Protonica-Detectors/hw-front-end/Output/Assembly/BOM-JLCPCB.csv

Comment | Designator | Footprint | LCSC Part #
10u GRM31CR71E106KA12L | C102,C104,C205,C206,C317,C318,C319,C320 | 1206 | C77093
100n GCM21BR72A104KA37L | C103,C201,C203,C204,C301,C302,C306,C307,C308,C311,C312,C313,C314,C315,C316 | 0805 | C85866
1u GRM21BR71H105KA12L | C202 | 0805 | C77083
4.7u GRM21BR71C475KE51L | C303,C304,C305 | 0805 | C408144
220p 0805CG221J500NT | C309,C310 | 0805 | C1805
SMAJ5.0A SMAJ5.0A | D101 | DO-214AC(SMA) | C83329
SMAJ12A SMAJ12A | D102 | DO-214AC(SMA) | C148213
BHR-24-VUA BHR-24-VUA | J101 | TH-24P,P=2.54mm | C7433299
Conn_02x04_Pin M20-9760442 | J201,J202 | Plugin,P=2.54mm | C5757776
Conn_02x06_Pin M20-9760642 | J301,J302,J303,J304 | Plugin,P=2.54mm | C5757778
2.2u MLF2012A2R2KT000 | L301,L302 | 0805 | C136256
0R CRCW08050000Z0EA | R101,R303,R304 | 0805 | C844934
1k CRCW08051K00FKEA | R201 | 0805 | C844939
200R CRCW0805200RFKEA | R301,R302 | 0805 | C844828
10k CRCW080510K0FKEA | R305,R306,R307,R308 | 0805 | C844937
100R CRCW0805100RFKEA | R311,R312,R313,R314,R315,R316,R317,R318,R319,R320,R321,R322 | 0805 | C844936
49.9R CRCW080549R9FKEA | R323,R324 | 0805 | C844847
75R CRCW080575R0FKEA | R325,R326 | 0805 | C844859
USBLC6-4SC6 USBLC6-4SC6 | U101,U102,U103 | SOT-23-6L | C111212
STP16CP05XT STP16CP05XTTR | U201 | TSSOP-24-EP | C2969824
OPA2350 OPA2350UA/2K5 | U301,U302 | SOIC-8 | C55904
SN74LVC16244ADGGR SN74LVC16244ADGGR | U303 | TSSOP-48-6.1mm | C7822
74LVC2G32 SN74LVC2G32DCTR | U304 | MSOP-8 | C2862085
