Protonica-Detectors/hw-front-end/Output/Assembly/BOM-original.csv

Reference | Value | Footprint | MPN | Manufacturer | Voltage | Description | QUANTITY | DNP | EXCLUDE_FROM_BOM | EXCLUDE_FROM_BOARD
C102,C104,C205,C206,C317,C318,C319,C320 | 10u | Capacitor_SMD:C_1206_3216Metric_Pad1.33x1.80mm_HandSolder | GRM31CR71E106KA12L | Murata Electronics | 25V | CAP CER 10UF 25V X7R 1206 | 8
C103,C201,C203,C204,C301,C302,C306,C307,C308,C311,C312,C313,C314,C315,C316 | 100n | Capacitor_SMD:C_0805_2012Metric_Pad1.18x1.45mm_HandSolder | GCM21BR72A104KA37L | Murata Electronics | 100V | CAP CER 0.1UF 100V X7R 0805 | 15
C202 | 1u | Capacitor_SMD:C_0805_2012Metric_Pad1.18x1.45mm_HandSolder | GRM21BR71A105KA01L | Murata Electronics | 10V | CAP CER 1UF 10V X7R 0805 | 1
C303,C304,C305 | 4.7u | Capacitor_SMD:C_0805_2012Metric_Pad1.18x1.45mm_HandSolder | GRM21BR71C475KE51L | Murata Electronics | 16V | CAP CER 4.7UF 16V X7R 0805 | 3
C309,C310 | 220p | Capacitor_SMD:C_0805_2012Metric_Pad1.18x1.45mm_HandSolder | C0805C221J5RACTU | Kemet | 50V | Unpolarized capacitor | 2
D101 | SMAJ5.0A | Diode_SMD:D_SMA | SMAJ5.0A | Littelfuse |  | 400W unidirectional Transient Voltage Suppressor, 5.0Vr, SMA(DO-214AC) | 1
D102 | SMAJ12A | Diode_SMD:D_SMA | SMAJ12A | Littelfuse |  | 400W unidirectional Transient Voltage Suppressor, 12.0Vr, SMA(DO-214AC) | 1
J101 | BHR-24-VUA | Connector_IDC:IDC-Header_2x12_P2.54mm_Vertical | BHR-24-VUA | Adam Tech |  | Generic connector, double row, 02x12, odd/even pin numbering scheme (row 1 odd numbers, row 2 even numbers), script generated (kicad-library-utils/schlib/autogen/connector/) | 1
J201,J202 | Conn_02x04_Pin | Connector_IDC:IDC-Header_2x04_P2.54mm_Vertical | M20-9760442 | Harwin Inc. |  | CONN HEADER VERT 8POS 2.54MM | 2
J301,J302,J303,J304 | Conn_02x06_Pin | Connector_IDC:IDC-Header_2x06_P2.54mm_Vertical | M20-9760642 | Harwin Inc. |  | CONN HEADER VERT 12POS 2.54MM | 4
L301,L302 | 2.2u | Inductor_SMD:L_0805_2012Metric | 74479052 | Würth Elektronik |  | Inductor | 2
R101,R303,R304 | 0R | Resistor_SMD:R_0805_2012Metric_Pad1.20x1.40mm_HandSolder | CRCW08050000Z0EA | Vishay Dale |  | RES SMD 0 OHM JUMPER 1/8W 0805 | 3
R201 | 1k | Resistor_SMD:R_0805_2012Metric_Pad1.20x1.40mm_HandSolder | CRCW08051K00FKEA | Vishay Dale |  | RES SMD 1K OHM 1% 1/4W 0805 | 1
R301,R302 | 200R | Resistor_SMD:R_0805_2012Metric_Pad1.20x1.40mm_HandSolder | CRCW0805200RFKEA | Vishay Dale |  | RES SMD 200 OHM 1% 1/8W 0805 | 2
R305,R306,R307,R308 | 10k | Resistor_SMD:R_0805_2012Metric_Pad1.20x1.40mm_HandSolder | CRCW080510K0FKEA | Vishay Dale |  | RES SMD 10K OHM 1% 1/8W 0805 | 4
R311,R312,R313,R314,R315,R316,R317,R318,R319,R320,R321,R322 | 100R | Resistor_SMD:R_0805_2012Metric_Pad1.20x1.40mm_HandSolder | CRCW0805100RFKEA | Vishay Dale |  | RES SMD 100 OHM 1% 1/8W 0805 | 12
R323,R324 | 49.9R | Resistor_SMD:R_0805_2012Metric_Pad1.20x1.40mm_HandSolder | CRCW080549R9FKEA | Vishay Dale |  | RES SMD 49.9 OHM 1% 1/8W 0805 | 2
R325,R326 | 75R | Resistor_SMD:R_0805_2012Metric_Pad1.20x1.40mm_HandSolder | CRCW080575R0FKEA | Vishay Dale |  | RES SMD 75 OHM 1% 1/8W 0805 | 2
U101,U102,U103 | USBLC6-4SC6 | Package_TO_SOT_SMD:SOT-23-6 | USBLC6-4SC6 | STMicroelectronics |  | Very low capacitance ESD protection diode, 4 data-line, SOT-23-6 | 3
U201 | STP16CP05XT | Package_SO:HTSSOP-24-1EP_4.4x7.8mm_P0.65mm_EP3.2x5mm | STP16CP05XTTR | STMicroelectronics |  | 16-bit constant current LED sink driver, 5..100mA output current, 20V driving capability, 3.0..5.5V power supply, HTSSOP-24 | 1
U301,U302 | OPA2350 | Package_SO:SOIC-8_3.9x4.9mm_P1.27mm | OPA2350UA/2K5 | Texas Instruments |  | IC OPAMP GP 1 CIRCUIT 8SOIC | 2
U303 | SN74LVC16244ADGGR | Package_SO:TSSOP-48_6.1x12.5mm_P0.5mm | SN74LVC16244ADGGR | Texas Instruments |  | IC BUFF 1.65V/3.6V 48-TSSOP | 1
U304 | 74LVC2G32 | Package_SO:VSSOP-8_3x3mm_P0.65mm | SN74LVC2G32DCTR | Texas Instruments |  | Dual OR Gate, Low-Voltage CMOS | 1
