Protonica-Detectors/hw-front-end/hw-front-end.kicad_pcb

## KiCad design hw-front-end.kicad_pcb (2026-11-10)

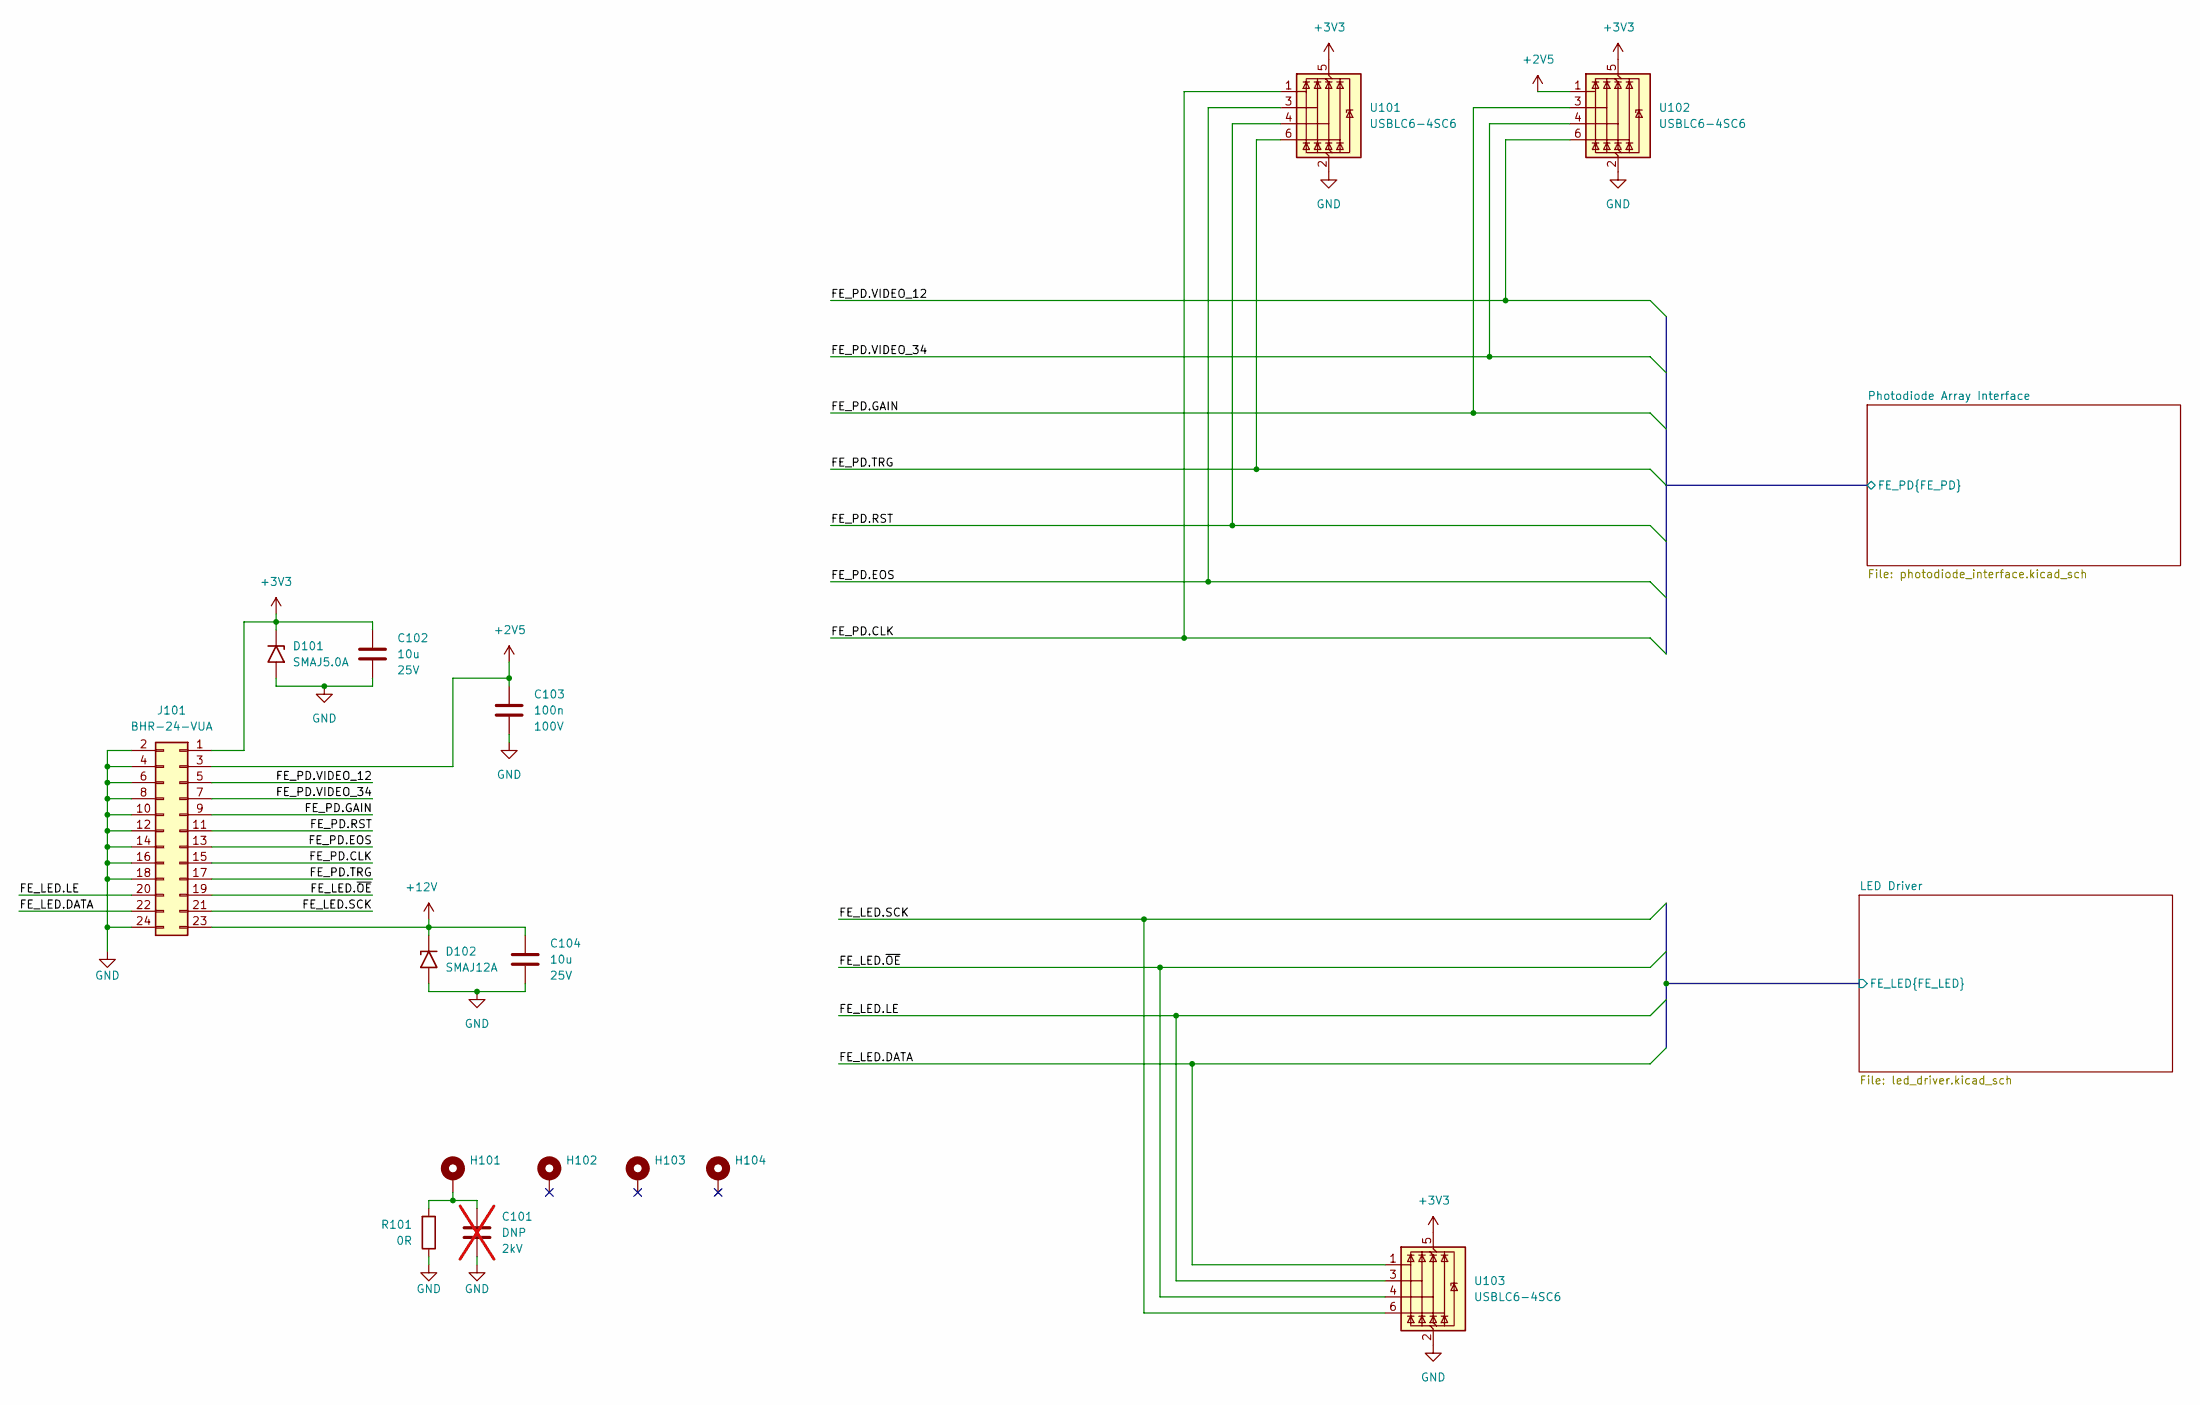
[picture p1: schematic hw-front-end.kicad_sch, Front End Electronics]

Parts:
C101: DNP; C_1206_3216Metric_Pad1.33x1.80mm_HandSolder; Voltage 2kV; not fitted
C102, C104: 10u; C_1206_3216Metric_Pad1.33x1.80mm_HandSolder; Voltage 25V; MPN GRM31CR71E106KA12L
C103: 100n; C_0805_2012Metric_Pad1.18x1.45mm_HandSolder; Voltage 100V; MPN GCM21BR72A104KA37L
D101: SMAJ5.0A; D_SMA; MPN SMAJ5.0A
D102: SMAJ12A; D_SMA; MPN SMAJ12A
H101, H102, H103, H104: MountingHole_Pad; MountingHole_3.2mm_M3_DIN965_Pad_TopBottom
J101: BHR-24-VUA; IDC-Header_2x12_P2.54mm_Vertical; MPN BHR-24-VUA
R101: 0R; R_0805_2012Metric_Pad1.20x1.40mm_HandSolder; MPN CRCW08050000Z0EA
U101, U102, U103: USBLC6-4SC6; SOT-23-6; MPN USBLC6-4SC6

Connections:
+2V5: C103.1, J101.3, U102.1 (I/O1); also elsewhere on the board
+3V3: C102.1, D101.1 (A1), J101.1, U101.5 (VBUS), U102.5 (VBUS), U103.5 (VBUS); also elsewhere on the board
+12V: C104.1, D102.1 (A1), J101.23; also elsewhere on the board
/LED Driver/FE_LED.DATA: J101.22, U103.1 (I/O1); also elsewhere on the board
/LED Driver/FE_LED.LE: J101.20, U103.3 (I/O2); also elsewhere on the board
/LED Driver/FE_LED.SCK: J101.21, U103.6 (I/O4); also elsewhere on the board
/LED Driver/FE_LED.~OE: J101.19, U103.4 (I/O3); also elsewhere on the board
/Photodiode Array Interface/FE_PD.CLK: J101.15, U101.1 (I/O1); also elsewhere on the board
/Photodiode Array Interface/FE_PD.EOS: J101.13, U101.3 (I/O2); also elsewhere on the board
/Photodiode Array Interface/FE_PD.GAIN: J101.9, U102.3 (I/O2); also elsewhere on the board
/Photodiode Array Interface/FE_PD.RST: J101.11, U101.4 (I/O3); also elsewhere on the board
/Photodiode Array Interface/FE_PD.TRG: J101.17, U101.6 (I/O4); also elsewhere on the board
/Photodiode Array Interface/FE_PD.VIDEO_12: J101.5, U102.6 (I/O4); also elsewhere on the board
/Photodiode Array Interface/FE_PD.VIDEO_34: J101.7, U102.4 (I/O3); also elsewhere on the board
GND: C101.2, C102.2, C103.2, C104.2, D101.2 (A2), D102.2 (A2), J101.2, J101.4, J101.6, J101.8, J101.10, J101.12, J101.14, J101.16, J101.18, J101.24, R101.1, U101.2 (GND), U102.2 (GND), U103.2 (GND); also elsewhere on the board
unnamed: C101.1, H101.1 (1_1), R101.2

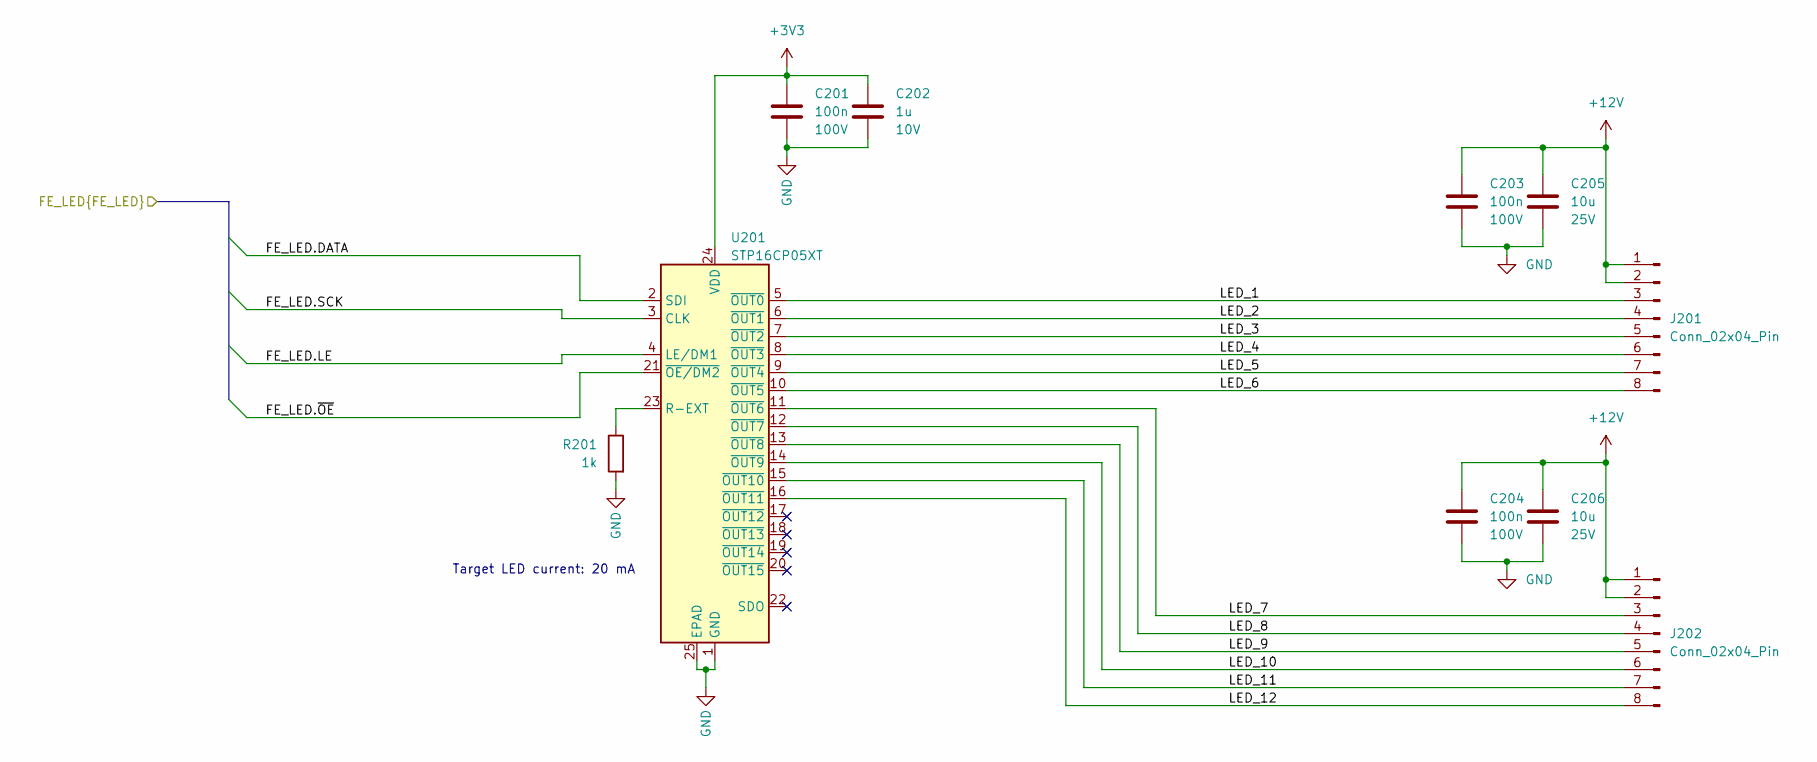
[picture p2: schematic led_driver.kicad_sch, Front End Electronics]

Parts:
C201, C203, C204: 100n; C_0805_2012Metric_Pad1.18x1.45mm_HandSolder; Voltage 100V; MPN GCM21BR72A104KA37L
C202: 1u; C_0805_2012Metric_Pad1.18x1.45mm_HandSolder; Voltage 10V; MPN GRM21BR71A105KA01L
C205, C206: 10u; C_1206_3216Metric_Pad1.33x1.80mm_HandSolder; Voltage 25V; MPN GRM31CR71E106KA12L
J201, J202: Conn_02x04_Pin; IDC-Header_2x04_P2.54mm_Vertical; MPN BHR-08-VUA
R201: 1k; R_0805_2012Metric_Pad1.20x1.40mm_HandSolder; MPN CRCW08051K00FKEA
U201: STP16CP05XT; HTSSOP-24-1EP_4.4x7.8mm_P0.65mm_EP3.2x5mm; MPN STP16CP05XTTR

Connections:
+3V3: C201.1, C202.1, U201.24 (VDD); also elsewhere on the board
+12V: C203.1, C204.1, C205.1, C206.1, J201.1, J201.2, J202.1, J202.2; also elsewhere on the board
/LED Driver/FE_LED.DATA: U201.2 (SDI); also elsewhere on the board
/LED Driver/FE_LED.LE: U201.4 (LE/DM1); also elsewhere on the board
/LED Driver/FE_LED.SCK: U201.3 (CLK); also elsewhere on the board
/LED Driver/FE_LED.~OE: U201.21 (~OE/DM2); also elsewhere on the board
/LED Driver/LED_1: J201.3, U201.5 (~OUT0)
/LED Driver/LED_2: J201.4, U201.6 (~OUT1)
/LED Driver/LED_3: J201.5, U201.7 (~OUT2)
/LED Driver/LED_4: J201.6, U201.8 (~OUT3)
/LED Driver/LED_5: J201.7, U201.9 (~OUT4)
/LED Driver/LED_6: J201.8, U201.10 (~OUT5)
/LED Driver/LED_7: J202.3, U201.11 (~OUT6)
/LED Driver/LED_8: J202.4, U201.12 (~OUT7)
/LED Driver/LED_9: J202.5, U201.13 (~OUT8)
/LED Driver/LED_10: J202.6, U201.14 (~OUT9)
/LED Driver/LED_11: J202.7, U201.15 (~OUT10)
/LED Driver/LED_12: J202.8, U201.16 (~OUT11)
GND: C201.2, C202.2, C203.2, C204.2, C205.2, C206.2, R201.2, U201.1 (GND), U201.25 (EPAD); also elsewhere on the board
unnamed: R201.1, U201.23 (R-EXT)

Notes on the sheet:
Target LED current: 20 mA

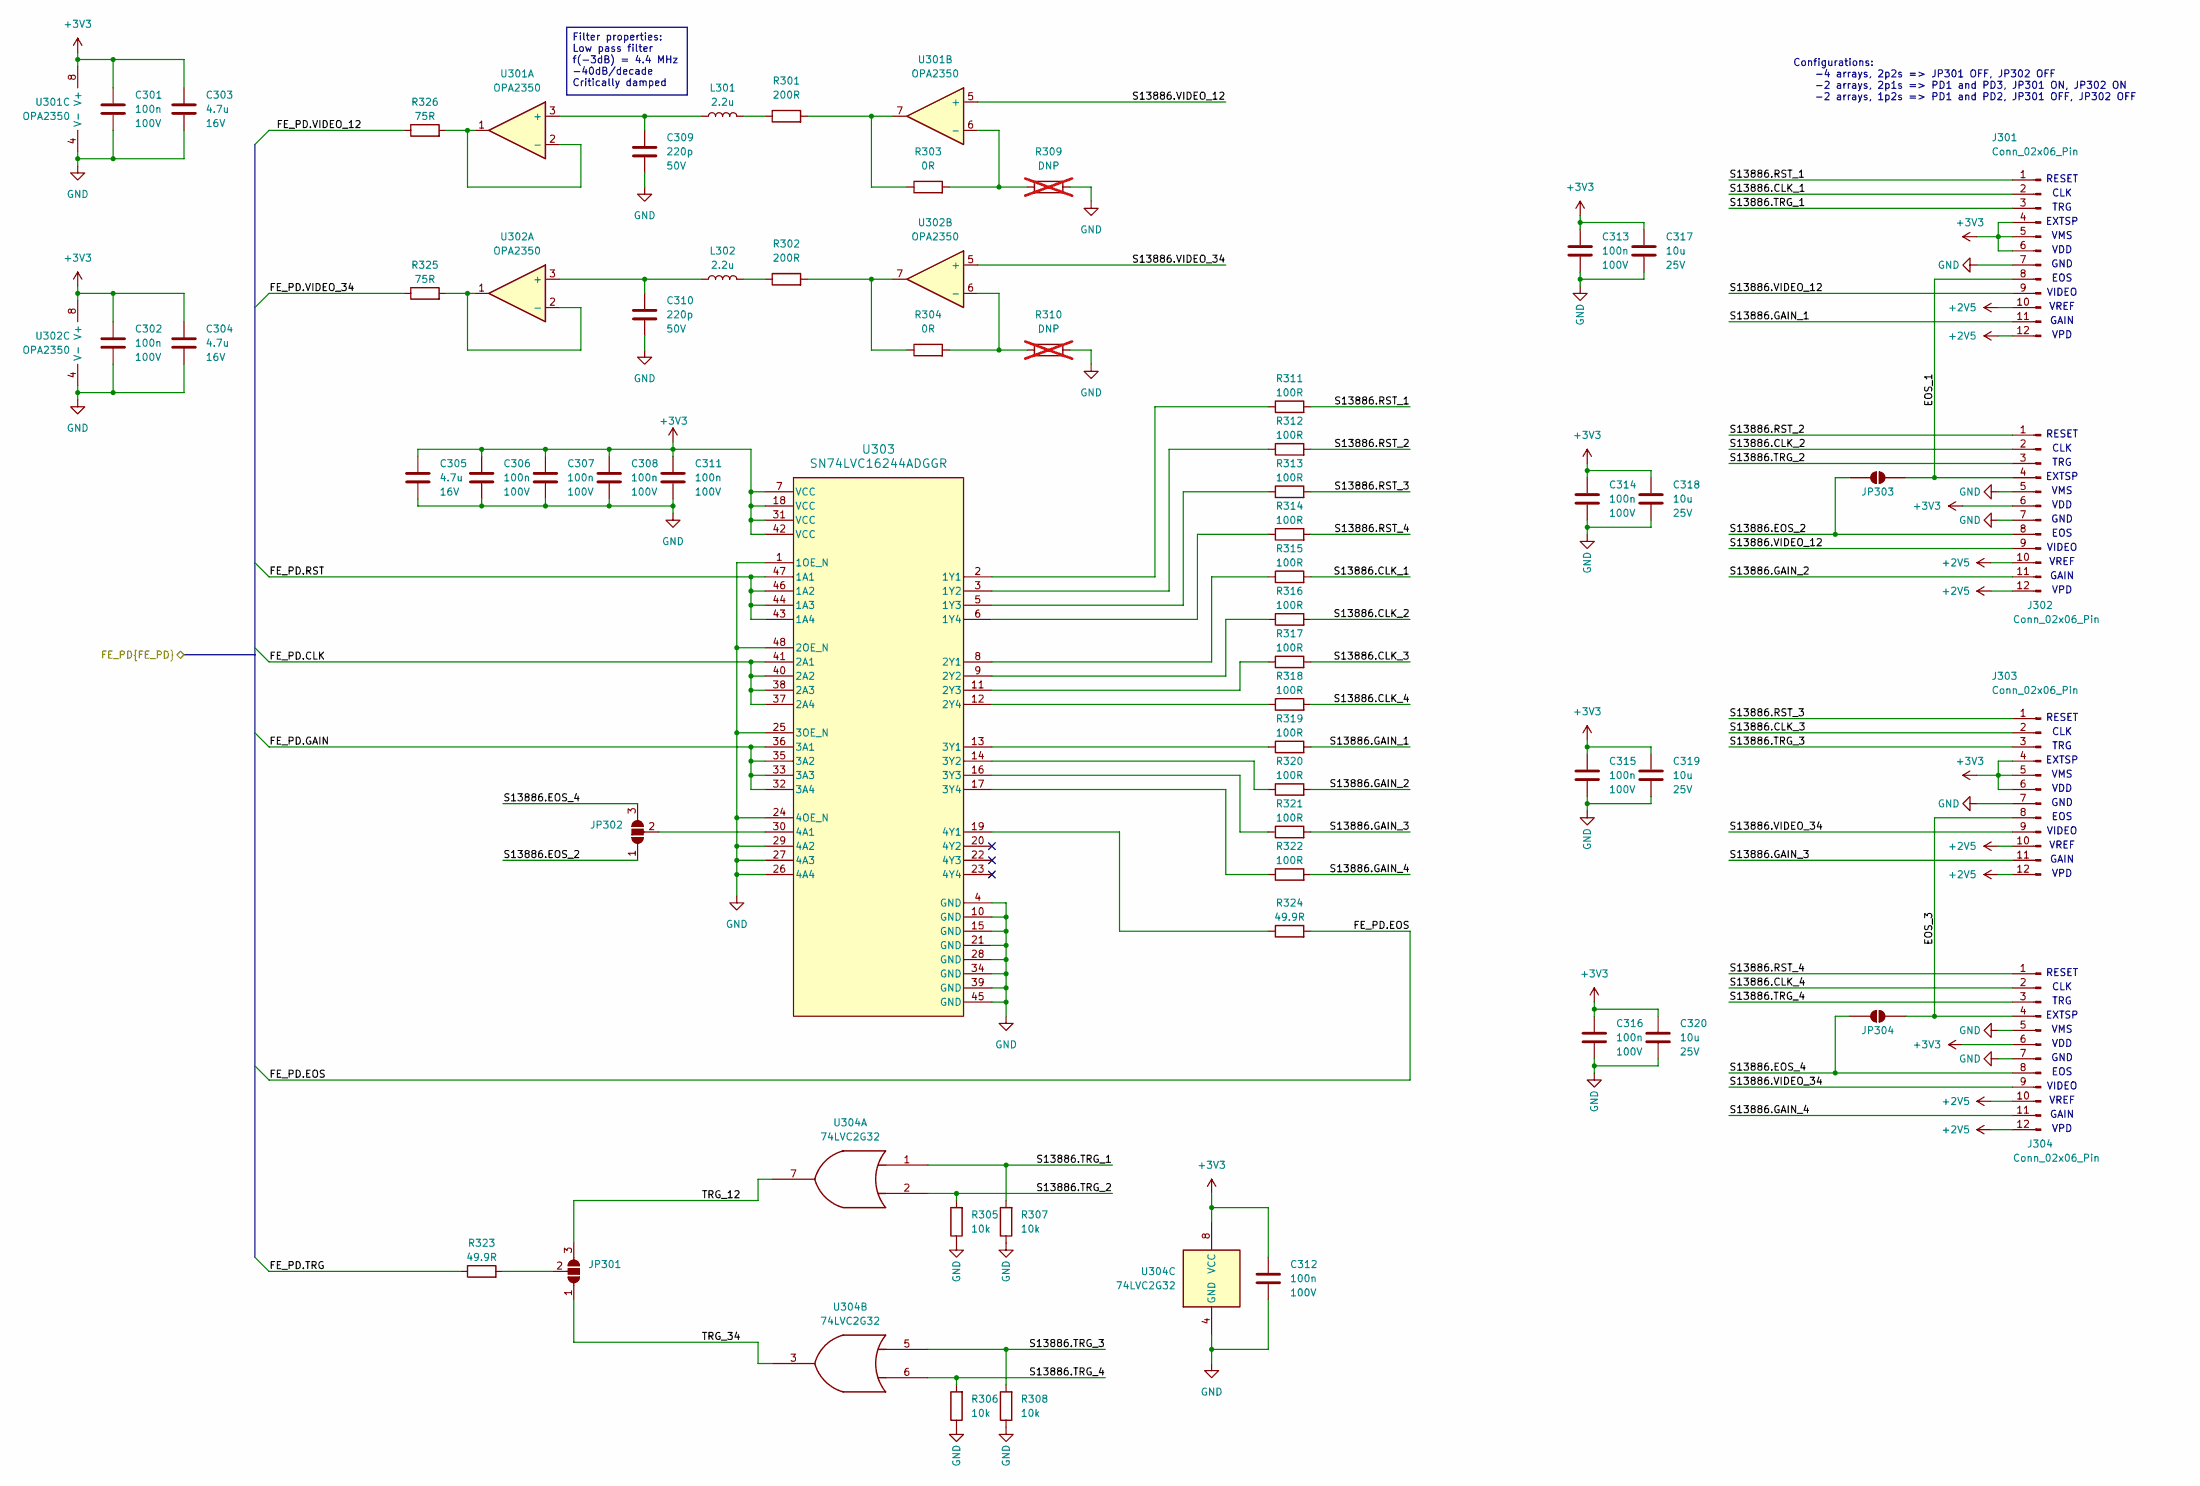
[picture p3: schematic photodiode_interface.kicad_sch, Front End Electronics]

Parts:
C301, C302, C306, C307, C308, C311, C312, C313, C314, C315, C316: 100n; C_0805_2012Metric_Pad1.18x1.45mm_HandSolder; Voltage 100V; MPN GCM21BR72A104KA37L
C303, C304, C305: 4.7u; C_0805_2012Metric_Pad1.18x1.45mm_HandSolder; Voltage 16V; MPN GRM21BR71C475KE51L
C309, C310: 220p; C_0805_2012Metric_Pad1.18x1.45mm_HandSolder; Voltage 50V; MPN C0805C221J5RACTU
C317, C318, C319, C320: 10u; C_1206_3216Metric_Pad1.33x1.80mm_HandSolder; Voltage 25V; MPN GRM31CR71E106KA12L
J301, J302, J303, J304: Conn_02x06_Pin; IDC-Header_2x06_P2.54mm_Vertical; MPN BHR-12-VUA
JP301, JP302: SolderJumper_3_Open; SolderJumper-3_P1.3mm_Open_Pad1.0x1.5mm
JP303, JP304: SolderJumper_2_Open; SolderJumper-2_P1.3mm_Open_Pad1.0x1.5mm
L301, L302: 2.2u; L_0805_2012Metric; MPN 74479052
R301, R302: 200R; R_0805_2012Metric_Pad1.20x1.40mm_HandSolder; MPN CRCW0805200RFKEA
R303, R304: 0R; R_0805_2012Metric_Pad1.20x1.40mm_HandSolder; MPN CRCW08050000Z0EA
R305, R306, R307, R308: 10k; R_0805_2012Metric_Pad1.20x1.40mm_HandSolder; MPN CRCW080510K0FKEA
R309, R310: DNP; R_0805_2012Metric_Pad1.20x1.40mm_HandSolder; not fitted
R311, R312, R313, R314, R315, R316, R317, R318, R319, R320, R321, R322: 100R; R_0805_2012Metric_Pad1.20x1.40mm_HandSolder; MPN CRCW0805100RFKEA
R323, R324: 49.9R; R_0805_2012Metric_Pad1.20x1.40mm_HandSolder; MPN CRCW080549R9FKEA
R325, R326: 75R; R_0805_2012Metric_Pad1.20x1.40mm_HandSolder; MPN CRCW080575R0FKEA
U301, U302: OPA2350; SOIC-8_3.9x4.9mm_P1.27mm; MPN OPA2350UA/2K5
U303: SN74LVC16244ADGGR; TSSOP-48_6.1x12.5mm_P0.5mm; MPN SN74LVC16244ADGGR
U304: 74LVC2G32; VSSOP-8_3x3mm_P0.65mm; MPN SN74LVC2G32DCTR

Connections:
+2V5: J301.10, J301.12, J302.10, J302.12, J303.10, J303.12, J304.10, J304.12; also elsewhere on the board
+3V3: C301.1, C302.1, C303.1, C304.1, C305.1, C306.1, C307.1, C308.1, C311.1, C312.1, C313.1, C314.1, C315.1, C316.1, C317.1, C318.1, C319.1, C320.1, J301.4, J301.5, J301.6, J302.6, J303.4, J303.5, J303.6, J304.6, U301.8 (V+), U302.8 (V+), U303.7 (VCC), U303.18 (VCC), U303.31 (VCC), U303.42 (VCC), U304.8 (VCC); also elsewhere on the board
/Photodiode Array Interface/EOS_1: J301.8, J302.4, JP303.1 (A)
/Photodiode Array Interface/EOS_3: J303.8, J304.4, JP304.1 (A)
/Photodiode Array Interface/FE_PD.CLK: U303.37 (2A4), U303.38 (2A3), U303.40 (2A2), U303.41 (2A1); also elsewhere on the board
/Photodiode Array Interface/FE_PD.EOS: R324.2; also elsewhere on the board
/Photodiode Array Interface/FE_PD.GAIN: U303.32 (3A4), U303.33 (3A3), U303.35 (3A2), U303.36 (3A1); also elsewhere on the board
/Photodiode Array Interface/FE_PD.RST: U303.43 (1A4), U303.44 (1A3), U303.46 (1A2), U303.47 (1A1); also elsewhere on the board
/Photodiode Array Interface/FE_PD.TRG: R323.1; also elsewhere on the board
/Photodiode Array Interface/FE_PD.VIDEO_12: R326.1; also elsewhere on the board
/Photodiode Array Interface/FE_PD.VIDEO_34: R325.1; also elsewhere on the board
/Photodiode Array Interface/S13886.CLK_1: J301.2, R315.2
/Photodiode Array Interface/S13886.CLK_2: J302.2, R316.2
/Photodiode Array Interface/S13886.CLK_3: J303.2, R317.2
/Photodiode Array Interface/S13886.CLK_4: J304.2, R318.2
/Photodiode Array Interface/S13886.EOS_2: J302.8, JP302.1 (A), JP303.2 (B)
/Photodiode Array Interface/S13886.EOS_4: J304.8, JP302.3 (B), JP304.2 (B)
/Photodiode Array Interface/S13886.GAIN_1: J301.11, R319.2
/Photodiode Array Interface/S13886.GAIN_2: J302.11, R320.2
/Photodiode Array Interface/S13886.GAIN_3: J303.11, R321.2
/Photodiode Array Interface/S13886.GAIN_4: J304.11, R322.2
/Photodiode Array Interface/S13886.RST_1: J301.1, R311.2
/Photodiode Array Interface/S13886.RST_2: J302.1, R312.2
/Photodiode Array Interface/S13886.RST_3: J303.1, R313.2
/Photodiode Array Interface/S13886.RST_4: J304.1, R314.2
/Photodiode Array Interface/S13886.TRG_1: J301.3, R307.2, U304.1
/Photodiode Array Interface/S13886.TRG_2: J302.3, R305.2, U304.2
/Photodiode Array Interface/S13886.TRG_3: J303.3, R308.2, U304.5
/Photodiode Array Interface/S13886.TRG_4: J304.3, R306.2, U304.6
/Photodiode Array Interface/S13886.VIDEO_12: J301.9, J302.9, U301.5 (+)
/Photodiode Array Interface/S13886.VIDEO_34: J303.9, J304.9, U302.5 (+)
/Photodiode Array Interface/TRG_12: JP301.3 (B), U304.7
/Photodiode Array Interface/TRG_34: JP301.1 (A), U304.3
GND: C301.2, C302.2, C303.2, C304.2, C305.2, C306.2, C307.2, C308.2, C309.2, C310.2, C311.2, C312.2, C313.2, C314.2, C315.2, C316.2, C317.2, C318.2, C319.2, C320.2, J301.7, J302.5, J302.7, J303.7, J304.5, J304.7, R305.1, R306.1, R307.1, R308.1, R309.2, R310.2, U301.4 (V-), U302.4 (V-), U303.1 (1OE_N), U303.4 (GND), U303.10 (GND), U303.15 (GND), U303.21 (GND), U303.24 (4OE_N), U303.25 (3OE_N), U303.26 (4A4), U303.27 (4A3), U303.28 (GND), U303.29 (4A2), U303.34 (GND), U303.39 (GND), U303.45 (GND), U303.48 (2OE_N), U304.4 (GND); also elsewhere on the board
unnamed: JP301.2 (C), R323.2
unnamed: JP302.2 (C), U303.30 (4A1)
unnamed: L301.2, R301.1
unnamed: L302.2, R302.1
unnamed: R301.2, R303.1, U301.7
unnamed: R302.2, R304.1, U302.7
unnamed: C309.1, L301.1, U301.3 (+)
unnamed: R326.2, U301.1, U301.2 (-)
unnamed: R303.2, R309.1, U301.6 (-)
unnamed: C310.1, L302.1, U302.3 (+)
unnamed: R325.2, U302.1, U302.2 (-)
unnamed: R304.2, R310.1, U302.6 (-)
unnamed: R311.1, U303.2 (1Y1)
unnamed: R312.1, U303.3 (1Y2)
unnamed: R313.1, U303.5 (1Y3)
unnamed: R314.1, U303.6 (1Y4)
unnamed: R315.1, U303.8 (2Y1)
unnamed: R316.1, U303.9 (2Y2)
unnamed: R317.1, U303.11 (2Y3)
unnamed: R318.1, U303.12 (2Y4)
unnamed: R319.1, U303.13 (3Y1)
unnamed: R320.1, U303.14 (3Y2)
unnamed: R321.1, U303.16 (3Y3)
unnamed: R322.1, U303.17 (3Y4)
unnamed: R324.1, U303.19 (4Y1)

Notes on the sheet:
EXTSP
Configurations: -4 arrays, 2p2s => JP301 OFF, JP302 OFF -2 arrays, 2p1s => PD1 and PD3, JP301 ON, JP302 ON -2 arrays, 1p2s => PD1 and PD2, JP301 OFF, JP302 OFF
GND
TRG
VPD
VDD
VIDEO
CLK
EOS
GAIN
RESET
VMS
VREF
Filter properties: Low pass filter f(-3dB) = 4.4 MHz -40dB/decade Critically damped

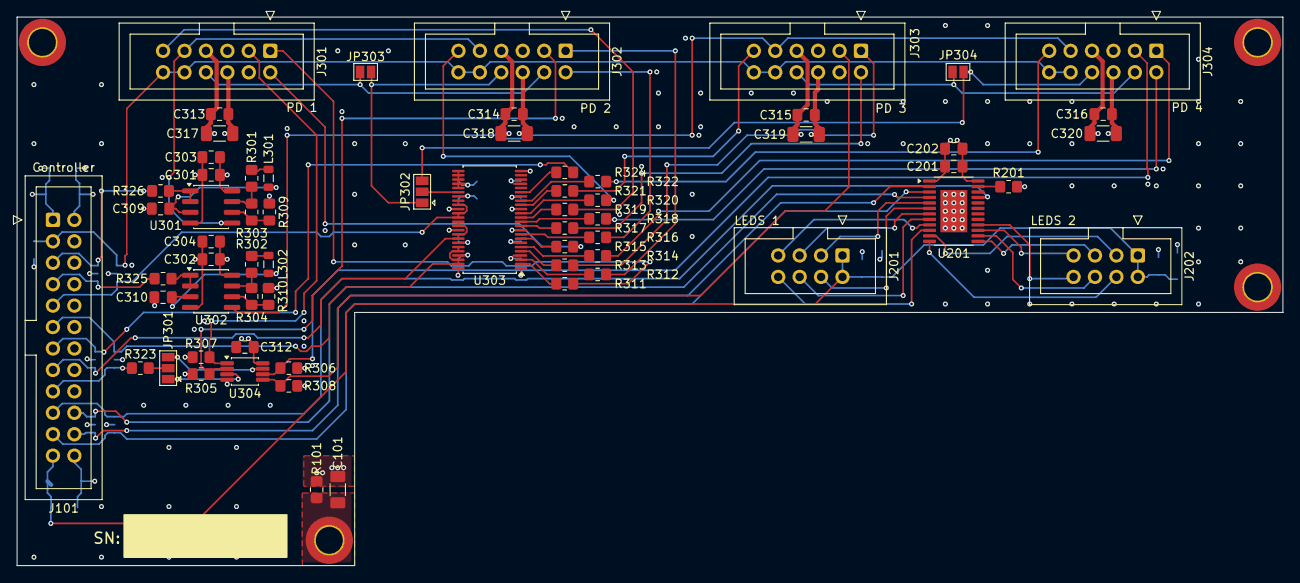
[picture p4: board hw-front-end.kicad_pcb from above]

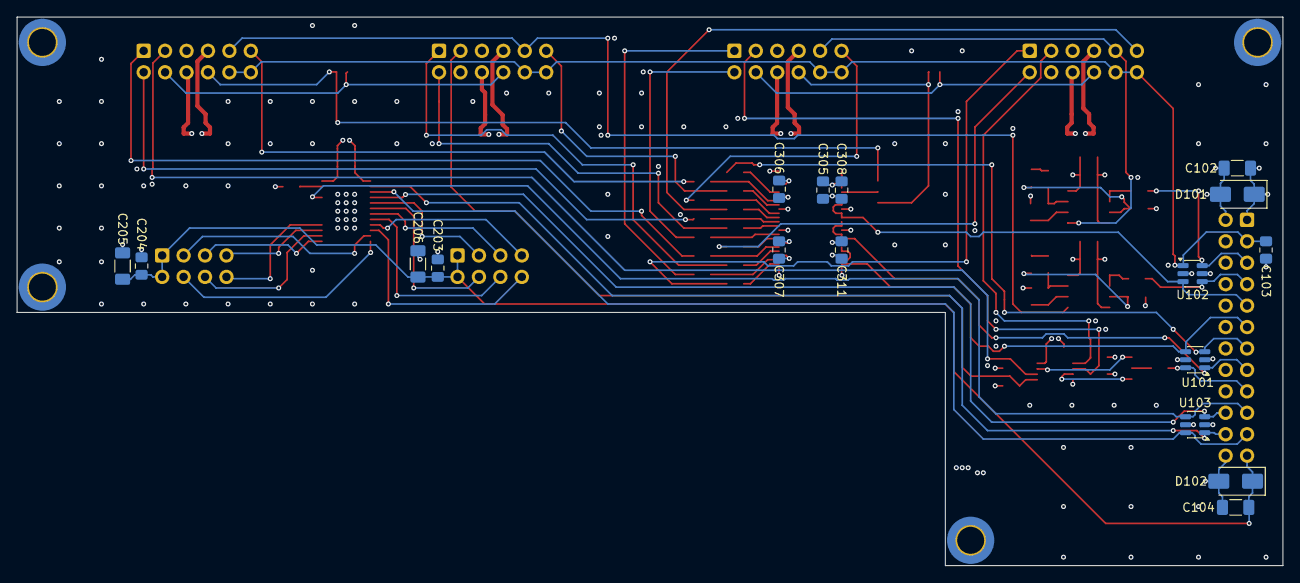
[picture p5: board hw-front-end.kicad_pcb from below]

Board: 6 copper layers, 150.0 x 65.0 mm, 85 parts (17 on the bottom side), 78 nets.
