Protonica-Detectors/hw-front-end/(commit log)

2026-11-05 drc clean
    [hw-front-end.kicad_pcb, hw-front-end.kicad_sch, led_driver.kicad_sch, photodiode_interface.kicad_sch]
2026-11-10 jlcpcb order 10.11.2026
    [hw-front-end.kicad_pcb, led_driver.kicad_sch, photodiode_interface.kicad_sch]
2026-11-10 add gerbers
    [BOM-JLCPCB-stock.csv, BOM-JLCPCB.csv, BOM-original.csv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]
